hoang1302/BOARD_ADS/hardware/v2.0/docs/images/user-2026-10-26/README.md

# Bộ ảnh board ADS V2 do tác giả cung cấp

_Cập nhật ngày 26/10/2026. Bộ ảnh chính được lấy từ IMAGE/3D của project V2._

## 🖼️ Top — cấu hình nRF52840

Board V2 với module nRF52840 và ADS1299

Ảnh `top_nRF52840.png` mô tả vị trí module nRF52840 được lắp, vị trí ESP32 để trống.

## 🖼️ Top — cấu hình ESP32

Board V2 với kit ESP32 và module ADS1299

Ảnh `top_esp32.png` mô tả kit ESP32 được lắp thay cho nRF52840. Hai cấu hình là lựa chọn thay thế; không cắm đồng thời hai bộ xử lý.

## 🖼️ Mặt dưới

Mặt dưới board V2 và mô hình boost

Ảnh `Bottom.png` thể hiện cụm nguồn U1/U2/U3 và mô hình module boost ở mặt dưới. Tất cả ảnh trên là hình CAD do tác giả cung cấp, chưa phải ảnh lắp ráp hoặc báo cáo DRC.

## 📋 Ảnh layout và schematic tham khảo

- [Top Layer 2D](2d_toplayer.png) và [Bottom Layer 2D](2d_bottomlayer.png) được giữ làm tài liệu xem routing; hai ảnh này không thay thế bộ ảnh 3D chính ở trên.
- [Schematic.png](Schematic.png) có thời điểm sửa ngày 19/10/2026; chưa xác nhận là schematic được xuất lại từ bản PCB ngày 26/10.

## 📋 Nguồn và phiên bản

Ảnh được sao chép nguyên byte, giữ nguyên tên, màu sắc, hướng và bố cục; không chỉnh sửa hoặc dựng lại bằng AI. [image-provenance.json](image-provenance.json) ghi kích thước, thời điểm file gốc và SHA-256. Nguồn Altium, BOM, pinout và Gerber không được thay thế trong lần cập nhật ảnh này.

[Giới thiệu linh kiện và cách hoạt động](../../BOARD_OVERVIEW.md) · [Ảnh 3D lịch sử ngày 25/10](../current-2026-10-25/README.md).
