hoang1302/BOARD_ADS/hardware/v2.0/docs/images/current-2026-10-25/README.md

# Ảnh PCB V2 ngày 25/10/2026

Các ảnh trong thư mục này được chụp trực tiếp từ chế độ 3D của Altium Designer 26.10.1.5, với tài liệu `BOARD_ADS _V2.0 (3).PcbDoc` đang mở và không có thay đổi chưa lưu. Mã SHA-256 của PCB đã lưu trùng file PCB V2 trong repository khi chụp.

| File | Nội dung |
| --- | --- |
| `board-3d-modules.png` | Mặt có module ADS1299, giắc VBAT và sáu giắc nguồn điện cực; hai vùng cắm bộ xử lý để trống |
| `board-3d-top.png` | Mặt có ba IC nguồn U1/U2/U3 và mô hình boost |
| `power-block.png` | Cận cảnh khối nguồn và mô hình boost, cắt từ ảnh mặt nguồn |

Ảnh được cắt từ khung nhìn Altium để lấy vùng board; không tạo lại linh kiện bằng AI và không thay đổi hình học PCB. Một số model cắm thêm hoặc chân nhô ra ngoài outline đúng như CAD đang hiển thị. Đây không phải ảnh lắp ráp, xác nhận cơ khí hay kết quả kiểm tra DRC.

Thông tin nguồn và SHA-256 ảnh nằm trong `image-provenance.json`. Ảnh cũ ngày 19–22/10 ở thư mục cha tiếp tục được giữ làm lịch sử.
