hoang1302/BOARD_ADS/hardware/v2.0/docs/PINOUT.md

# Pinout từ PCB đã lưu — V2.0

Đọc trực tiếp pad/net của PCB nguồn ngày 25/10/2026. Số pad là số trong Altium, không xác nhận chiều nhìn hoặc pinout module thực tế. Chưa chạy compile/ERC/ECO trong lần đóng gói này. Chỉ cắm ESP32 hoặc nRF52840 tại một thời điểm.

Tên connector bản hiện tại đã đổi sang H6–H12. Không dùng bảng J1–J10 từ các bản review cũ để đấu dây cho bản này.

## H1 — header_22p

| Pad | Net PCB |
| --- | --- |
| 1 | 3V3 |
| 2 | 3V3 |
| 3 | Không gán net |
| 4 | DRDY |
| 5 | START |
| 6 | RESET |
| 7 | PWDN |
| 8 | Không gán net |
| 9 | Không gán net |
| 10 | Không gán net |
| 11 | Không gán net |
| 12 | Không gán net |
| 13 | Không gán net |
| 14 | Không gán net |
| 15 | Không gán net |
| 16 | CS |
| 17 | MOSI |
| 18 | SCLK |
| 19 | MISO |
| 20 | Không gán net |
| 21 | 5V |
| 22 | GND |

## H2 — header_22p

| Pad | Net PCB |
| --- | --- |
| 1 | GND |
| 2 | Không gán net |
| 3 | Không gán net |
| 4 | Không gán net |
| 5 | Không gán net |
| 6 | Không gán net |
| 7 | Không gán net |
| 8 | Không gán net |
| 9 | Không gán net |
| 10 | Không gán net |
| 11 | Không gán net |
| 12 | Không gán net |
| 13 | Không gán net |
| 14 | Không gán net |
| 15 | Không gán net |
| 16 | Không gán net |
| 17 | Không gán net |
| 18 | Không gán net |
| 19 | Không gán net |
| 20 | Không gán net |
| 21 | GND |
| 22 | GND |

## H3 — HEADER_13P

| Pad | Net PCB |
| --- | --- |
| 1 | PWDN |
| 2 | RESET |
| 3 | START |
| 4 | DRDY |
| 5 | CS |
| 6 | MISO |
| 7 | MOSI |
| 8 | SCLK |
| 9 | GND |
| 10 | Không gán net |
| 11 | Không gán net |
| 12 | Không gán net |
| 13 | GND |

## H4 — MODULE ADS1299

| Pad | Net PCB |
| --- | --- |
| 1 | 3V3 |
| 2 | GND |
| 3 | Không gán net |
| 4 | DRDY |
| 5 | MISO |
| 6 | Không gán net |
| 7 | SCLK |
| 8 | START |
| 9 | RESET |
| 10 | PWDN |
| 11 | MOSI |
| 12 | Không gán net |
| 13 | CS |

## H5 — HEADER_13P

| Pad | Net PCB |
| --- | --- |
| 1 | VBAT |
| 2 | Không gán net |
| 3 | GND |
| 4 | Không gán net |
| 5 | 3V3 |
| 6 | Không gán net |
| 7 | Không gán net |
| 8 | Không gán net |
| 9 | Không gán net |
| 10 | Không gán net |
| 11 | Không gán net |
| 12 | Không gán net |
| 13 | Không gán net |

## H6 — XH2.54M-2

| Pad | Net PCB |
| --- | --- |
| 1 | GND |
| 2 | VBAT |

## H7 — XH2.54M-2

| Pad | Net PCB |
| --- | --- |
| 1 | 2V5 |
| 2 | -2V5 |

## H8 — XH2.54M-2

| Pad | Net PCB |
| --- | --- |
| 1 | 2V5 |
| 2 | -2V5 |

## H9 — XH2.54M-2

| Pad | Net PCB |
| --- | --- |
| 1 | 2V5 |
| 2 | -2V5 |

## H10 — XH2.54M-2

| Pad | Net PCB |
| --- | --- |
| 1 | 2V5 |
| 2 | -2V5 |

## H11 — XH2.54M-2

| Pad | Net PCB |
| --- | --- |
| 1 | 2V5 |
| 2 | -2V5 |

## H12 — XH2.54M-2

| Pad | Net PCB |
| --- | --- |
| 1 | 2V5 |
| 2 | -2V5 |

## TP1 — TP_SMD_1P50

| Pad | Net PCB |
| --- | --- |
| 1 | VBAT |

## TP2 — TP_SMD_1P50

| Pad | Net PCB |
| --- | --- |
| 1 | -2V5 |

## TP3 — TP_SMD_1P50

| Pad | Net PCB |
| --- | --- |
| 1 | 2V5 |

## TP4 — TP_SMD_1P50

| Pad | Net PCB |
| --- | --- |
| 1 | VBAT_NEG |

## TP5 — TP_SMD_1P50

| Pad | Net PCB |
| --- | --- |
| 1 | GND |
