hoang1302/BOARD_ADS/hardware/v2.0/docs/images/2026-10-19_2d.png

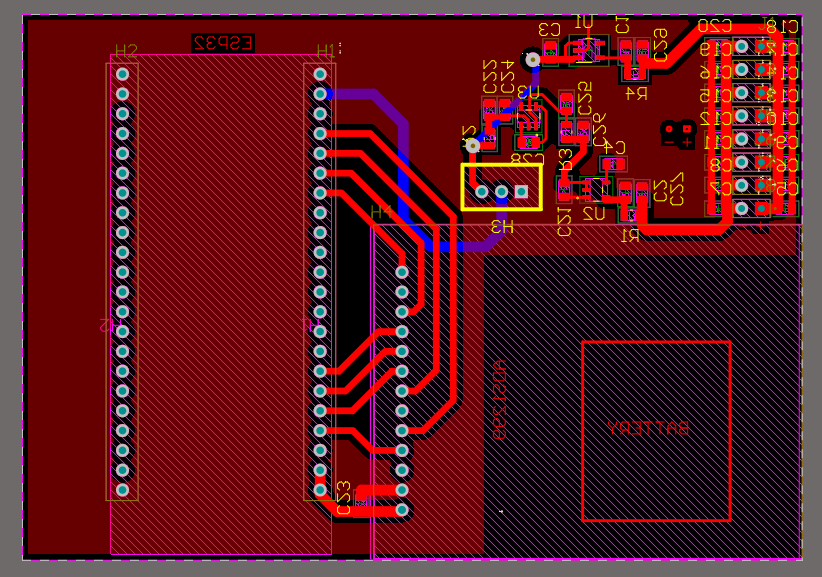
hardware/v2.0/docs/images/2026-10-19_2d.png
