hoang1302/BOARD_ADS/hardware/v2.0/docs/images/2026-10-19_3d_bottom.png

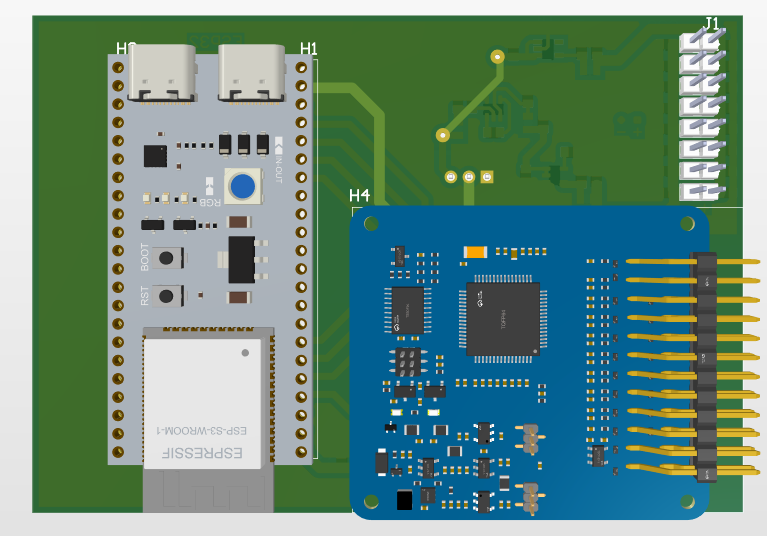
hardware/v2.0/docs/images/2026-10-19_3d_bottom.png
