hoang1302/BOARD_ADS/hardware/v2.0/docs/images/2026-10-22_3D_with_nRF.png

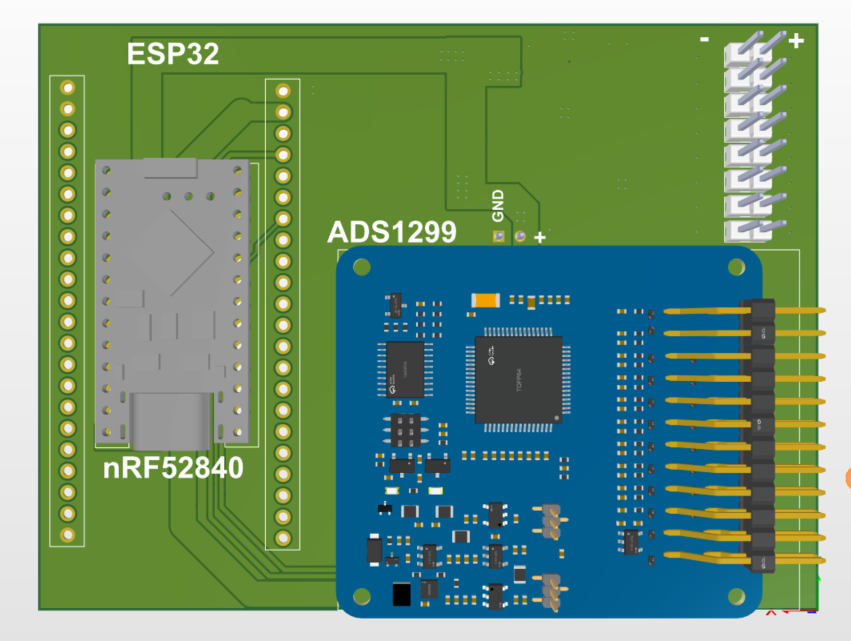
hardware/v2.0/docs/images/2026-10-22_3D_with_nRF.png
