hoang1302/BOARD_ADS/hardware/v2.0/docs/images/current-2026-10-25/board-3d-top.png

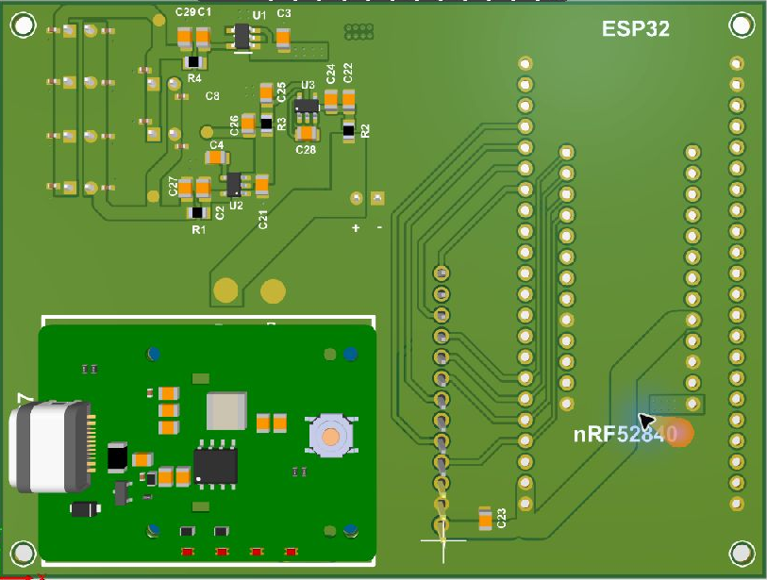
hardware/v2.0/docs/images/current-2026-10-25/board-3d-top.png
