hoang1302/BOARD_ADS/hardware/v2.0/docs/images/current-2026-10-25/power-block.png

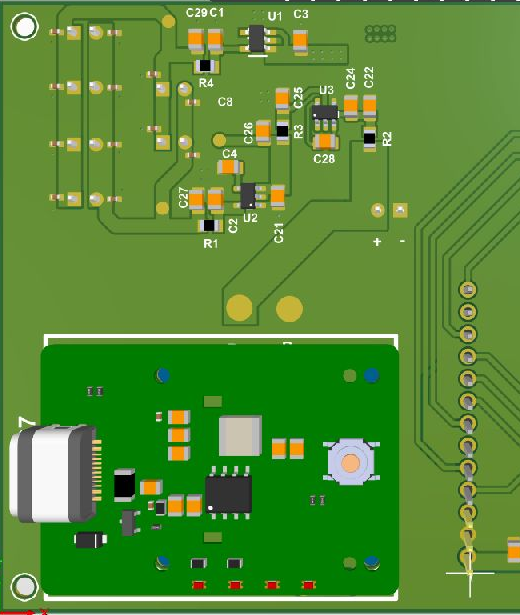
hardware/v2.0/docs/images/current-2026-10-25/power-block.png
