hoang1302/BOARD_ADS/hardware/v2.0/docs/images/user-2026-10-26/2d_bottomlayer.png

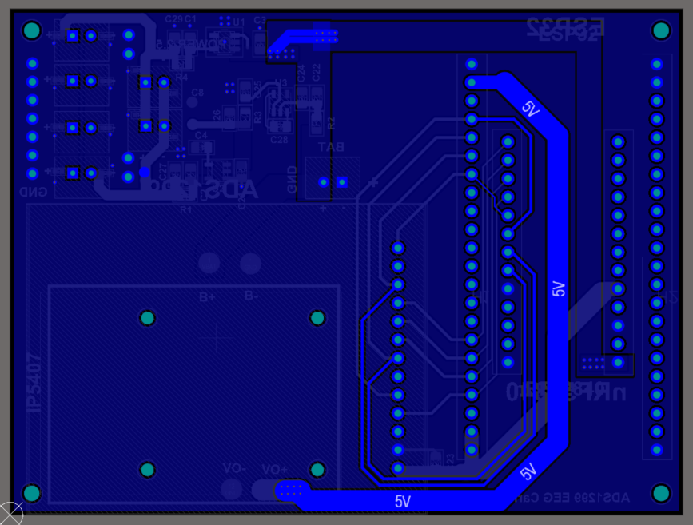
hardware/v2.0/docs/images/user-2026-10-26/2d_bottomlayer.png
