hoang1302/BOARD_ADS/hardware/bom/BOM.md

# Danh sách linh kiện tham khảo

Trích từ schematic đã lưu khi đóng gói ngày 15/10/2026, gồm **48 designator**. Bảng này phục vụ xem thiết kế, chưa phải BOM mua hàng hoặc BOM lắp ráp đã duyệt.

Giá trị lấy từ Comment; nếu Comment là `=Value1` thì đọc parameter Value1. Các trường chưa khai báo được giữ rõ là chưa có dữ liệu. Không dùng các placeholder `SET_VALUE`/`SET_VOLTAGE` để suy ra thông số linh kiện.

Footprint lấy từ PCB đã lưu. Cột Case là parameter trên schematic, chưa phải xác nhận kích thước thực tế. MPN chỉ lấy từ trường dữ liệu đã khai báo; không tự chọn mã thay thế. Các symbol module/header không mặc định bao gồm module hoặc kit tương ứng trong đơn mua hàng.

| Designator | Giá trị / chức năng | Footprint PCB | Case / Package khai báo | MPN khai báo | Trạng thái |
| --- | --- | --- | --- | --- | --- |
| C1 | 1uF | C0805L | 0402 | Chưa khai báo | Chưa chốt lắp ráp |
| C2 | 4.7uF | C0805L | 0402 | Chưa khai báo | Chưa chốt lắp ráp |
| C3 | 1uF | C0805L | 0402 | Chưa khai báo | Chưa chốt lắp ráp |
| C4 | 10nF | C0805L | 0402 | Chưa khai báo | Chưa chốt lắp ráp |
| C5 | 100nF | C0805L | 0402 | Chưa khai báo | Chưa chốt lắp ráp |
| C6 | 100nF | C0805L | 0402 | Chưa khai báo | Chưa chốt lắp ráp |
| C7 | 100nF | C0805L | 0402 | Chưa khai báo | Chưa chốt lắp ráp |
| C8 | 100nF | C0805L | 0402 | Chưa khai báo | Chưa chốt lắp ráp |
| C9 | 100nF | C0805L | 0402 | Chưa khai báo | Chưa chốt lắp ráp |
| C10 | 100nF | C0805L | 0402 | Chưa khai báo | Chưa chốt lắp ráp |
| C11 | 100nF | C0805L | 0402 | Chưa khai báo | Chưa chốt lắp ráp |
| C12 | 100nF | C0805L | 0402 | Chưa khai báo | Chưa chốt lắp ráp |
| C13 | 100nF | C0805L | 0402 | Chưa khai báo | Chưa chốt lắp ráp |
| C14 | 100nF | C0805L | 0402 | Chưa khai báo | Chưa chốt lắp ráp |
| C15 | 100nF | C0805L | 0402 | Chưa khai báo | Chưa chốt lắp ráp |
| C16 | 100nF | C0805L | 0402 | Chưa khai báo | Chưa chốt lắp ráp |
| C17 | 100nF | C0805L | 0402 | Chưa khai báo | Chưa chốt lắp ráp |
| C18 | 100nF | C0805L | 0402 | Chưa khai báo | Chưa chốt lắp ráp |
| C19 | 100nF | C0805L | 0402 | Chưa khai báo | Chưa chốt lắp ráp |
| C20 | 100nF | C0805L | 0402 | Chưa khai báo | Chưa chốt lắp ráp |
| C21 | 4.7uF | C0805L | 0402 | Chưa khai báo | Chưa chốt lắp ráp |
| C22 | 10uF | C0805L | 0402 | Chưa khai báo | Chưa chốt lắp ráp |
| C23 | 100nF | C0805L | 0402 | Chưa khai báo | Chưa chốt lắp ráp |
| C24 | 1uF | C0805L | 0402 | Chưa khai báo | Chưa chốt lắp ráp |
| C25 | 1uF | C0805L | 0402 | Chưa khai báo | Chưa chốt lắp ráp |
| C26 | 10uF | C0805L | 0402 | Chưa khai báo | Chưa chốt lắp ráp |
| C27 | 10uF | C0805L | 0402 | Chưa khai báo | Chưa chốt lắp ráp |
| C28 | 1uF | C0805L | 0402 | Chưa khai báo | Chưa chốt lắp ráp |
| C29 | 10uF | C0805L | 0402 | Chưa khai báo | Chưa chốt lắp ráp |
| H1 | HEADER_22P | header_22p | Chưa khai báo | Chưa khai báo | Chưa chốt lắp ráp |
| H2 | HEADER_22P | header_22p | Chưa khai báo | Chưa khai báo | Chưa chốt lắp ráp |
| H3 | POWER | XH2.54M-3 | Chưa khai báo | Chưa khai báo | Chưa chốt lắp ráp |
| H4 | MODULE ADS | MODULE ADS1299 | Chưa khai báo | Chưa khai báo | Chưa chốt lắp ráp |
| J1 | HEADER 2P | HEADER_2P | Chưa khai báo | 3-644456-2 | Chưa chốt lắp ráp |
| J2 | HEADER 2P | HEADER_2P | Chưa khai báo | 3-644456-2 | Chưa chốt lắp ráp |
| J3 | HEADER 2P | HEADER_2P | Chưa khai báo | 3-644456-2 | Chưa chốt lắp ráp |
| J4 | HEADER 2P | HEADER_2P | Chưa khai báo | 3-644456-2 | Chưa chốt lắp ráp |
| J5 | HEADER 2P | HEADER_2P | Chưa khai báo | 3-644456-2 | Chưa chốt lắp ráp |
| J6 | HEADER 2P | HEADER_2P | Chưa khai báo | 3-644456-2 | Chưa chốt lắp ráp |
| J7 | HEADER 2P | HEADER_2P | Chưa khai báo | 3-644456-2 | Chưa chốt lắp ráp |
| J8 | HEADER 2P | HEADER_2P | Chưa khai báo | 3-644456-2 | Chưa chốt lắp ráp |
| R1 | 0R | R0805 | 0805 | Chưa khai báo | Chưa chốt lắp ráp |
| R2 | 0R | R0805 | 0805 | Chưa khai báo | Chưa chốt lắp ráp |
| R3 | 0R | R0805 | 0805 | Chưa khai báo | Chưa chốt lắp ráp |
| R4 | 0R | R0805 | 0805 | Chưa khai báo | Chưa chốt lắp ráp |
| U1 | LP5907MFX-2.5/NOPB | DBV0005A_M | Chưa khai báo | LP5907MFX-2.5/NOPB | Chưa chốt lắp ráp |
| U2 | TPS72325DBVR | SOT95P280X145-5N | SOT-23-5 Texas Instruments | TPS72325DBVR | Chưa chốt lắp ráp |
| U3 | TPS60403DBVR | SOT95P280X145-5N | SOT-23-5 Texas Instruments | TPS60403DBVR | Chưa chốt lắp ráp |

## Trước khi đặt linh kiện

- Chốt MPN, nhà sản xuất, dung sai, điện áp/công suất và package theo linh kiện thực tế.
- Đối chiếu schematic model với footprint PCB và bản vẽ linh kiện.
- Chốt linh kiện lắp, DNP, module mua riêng và yêu cầu connector.
- C1–C29 khai báo Case/Package = 0402, trong khi model hiện tại là C0805L. Cần xác nhận và đồng bộ trước khi lập BOM mua hàng.
