hoang1302/BOARD_ADS/hardware/v2.0/docs/BOM.md

# BOM tham khảo — BOARD_ADS V2.0

Trích từ schematic và PCB đã lưu ngày 25/10/2026, gồm 49 designator. Đây là BOM tham khảo, chưa phải BOM mua hàng hoặc lắp ráp đã duyệt. Footprint lấy từ PCB; Case và MPN lấy từ schematic, không tự suy ra mã mua hàng từ tên footprint.

| Designator | Giá trị / Comment | Symbol | Footprint PCB | Case khai báo | MPN khai báo |
| --- | --- | --- | --- | --- | --- |
| C1 | 1uF | C0805 | C0805L | 0402 | Chưa khai báo |
| C2 | 4.7uF | C0805 | C0805L | 0402 | Chưa khai báo |
| C3 | 1uF | C0805 | C0805L | 0402 | Chưa khai báo |
| C4 | 10nF | C0805 | C0805L | 0402 | Chưa khai báo |
| C5 | 100nF | C0805 | C0402L | 0402 | Chưa khai báo |
| C6 | 100nF | C0805 | C0402L | 0402 | Chưa khai báo |
| C7 | 100nF | C0805 | C0402L | 0402 | Chưa khai báo |
| C8 | 100nF | C0805 | C0402L | 0402 | Chưa khai báo |
| C9 | 100nF | C0805 | C0402L | 0402 | Chưa khai báo |
| C10 | 100nF | C0805 | C0402L | 0402 | Chưa khai báo |
| C11 | 100nF | C0805 | C0402L | 0402 | Chưa khai báo |
| C12 | 100nF | C0805 | C0402L | 0402 | Chưa khai báo |
| C13 | 100nF | C0805 | C0402L | 0402 | Chưa khai báo |
| C14 | 100nF | C0805 | C0402L | 0402 | Chưa khai báo |
| C15 | 100nF | C0805 | C0402L | 0402 | Chưa khai báo |
| C16 | 100nF | C0805 | C0402L | 0402 | Chưa khai báo |
| C21 | 4.7uF | C0805 | C0805L | 0402 | Chưa khai báo |
| C22 | 10uF | C0805 | C0805L | 0402 | Chưa khai báo |
| C23 | 100nF | C0805 | C0805L | 0402 | Chưa khai báo |
| C24 | 1uF | C0805 | C0805L | 0402 | Chưa khai báo |
| C25 | 1uF | C0805 | C0805L | 0402 | Chưa khai báo |
| C26 | 10uF | C0805 | C0805L | 0402 | Chưa khai báo |
| C27 | 10uF | C0805 | C0805L | 0402 | Chưa khai báo |
| C28 | 1uF | C0805 | C0805L | 0402 | Chưa khai báo |
| C29 | 10uF | C0805 | C0805L | 0402 | Chưa khai báo |
| H1 | HEADER_22P | HEADER_22P | header_22p | Chưa khai báo | Chưa khai báo |
| H2 | HEADER_22P | HEADER_22P | header_22p | Chưa khai báo | Chưa khai báo |
| H3 | Header_13p | Header_13p | HEADER_13P | Chưa khai báo | Chưa khai báo |
| H4 | MODULE ADS | MODULE_ADS | MODULE ADS1299 | Chưa khai báo | Chưa khai báo |
| H5 | Header_13p | Header_13p | HEADER_13P | Chưa khai báo | Chưa khai báo |
| H6 | Header 2P 2.54 Duc Thang | Header 2P 2.54 Duc Thang | XH2.54M-2 | Chưa khai báo | Chưa khai báo |
| H7 | Header 2P 2.54 Duc Thang | Header 2P 2.54 Duc Thang | XH2.54M-2 | Chưa khai báo | Chưa khai báo |
| H8 | Header 2P 2.54 Duc Thang | Header 2P 2.54 Duc Thang | XH2.54M-2 | Chưa khai báo | Chưa khai báo |
| H9 | Header 2P 2.54 Duc Thang | Header 2P 2.54 Duc Thang | XH2.54M-2 | Chưa khai báo | Chưa khai báo |
| H10 | Header 2P 2.54 Duc Thang | Header 2P 2.54 Duc Thang | XH2.54M-2 | Chưa khai báo | Chưa khai báo |
| H11 | Header 2P 2.54 Duc Thang | Header 2P 2.54 Duc Thang | XH2.54M-2 | Chưa khai báo | Chưa khai báo |
| H12 | Header 2P 2.54 Duc Thang | Header 2P 2.54 Duc Thang | XH2.54M-2 | Chưa khai báo | Chưa khai báo |
| R1 | 0R | R0805 | R0805 | 0805 | Chưa khai báo |
| R2 | 0R | R0805 | R0805 | 0805 | Chưa khai báo |
| R3 | 0R | R0805 | R0805 | 0805 | Chưa khai báo |
| R4 | 0R | R0805 | R0805 | 0805 | Chưa khai báo |
| TP1 | TP_? | TEST_POINT | TP_SMD_1P50 | Chưa khai báo | Chưa khai báo |
| TP2 | TP_? | TEST_POINT | TP_SMD_1P50 | Chưa khai báo | Chưa khai báo |
| TP3 | TP_? | TEST_POINT | TP_SMD_1P50 | Chưa khai báo | Chưa khai báo |
| TP4 | TP_? | TEST_POINT | TP_SMD_1P50 | Chưa khai báo | Chưa khai báo |
| TP5 | TP_? | TEST_POINT | TP_SMD_1P50 | Chưa khai báo | Chưa khai báo |
| U1 | LP5907MFX-2.5/NOPB | LP5907MFX-2.5NOPB | DBV0005A_M | Chưa khai báo | LP5907MFX-2.5/NOPB |
| U2 | TPS72325DBVR | TPS72325DBVR | SOT95P280X145-5N | SOT-23-5 Texas Instruments | TPS72325DBVR |
| U3 | TPS60403DBVR | TPS60403DBVR | SOT95P280X145-5N | SOT-23-5 Texas Instruments | TPS60403DBVR |

## Các điểm cần đối chiếu trước khi mua

- Schematic còn nhiều tụ có Case/Package = 0402 trong khi footprint PCB là C0805L. C5–C16 đang dùng C0402L trên PCB; xem từng dòng và file nguồn trước khi cập nhật thư viện.
- H6–H12 dùng symbol `Header 2P 2.54 Duc Thang` nhưng footprint PCB là `XH2.54M-2`. Cần kiểm tra model schematic, hình học và giắc thực tế trước khi ECO/Update From Libraries.
- Test point có Comment `TP_?`; xem net tại bảng pinout để xác định chức năng.
- Chốt điện áp, dung sai, dòng tải, MPN và linh kiện/module mua riêng. Module ESP32, nRF52840, ADS1299 và boost không được tự coi là đã nằm trong BOM mua hàng chỉ vì có header hoặc 3D body.
