hoang1302/BOARD_ADS/hardware/v2.0/docs/BOM.csv

designator | value | symbol | pcb_footprint | case | mpn
C1 | 1uF | C0805 | C0805L | 0402
C2 | 4.7uF | C0805 | C0805L | 0402
C3 | 1uF | C0805 | C0805L | 0402
C4 | 10nF | C0805 | C0805L | 0402
C5 | 100nF | C0805 | C0402L | 0402
C6 | 100nF | C0805 | C0402L | 0402
C7 | 100nF | C0805 | C0402L | 0402
C8 | 100nF | C0805 | C0402L | 0402
C9 | 100nF | C0805 | C0402L | 0402
C10 | 100nF | C0805 | C0402L | 0402
C11 | 100nF | C0805 | C0402L | 0402
C12 | 100nF | C0805 | C0402L | 0402
C13 | 100nF | C0805 | C0402L | 0402
C14 | 100nF | C0805 | C0402L | 0402
C15 | 100nF | C0805 | C0402L | 0402
C16 | 100nF | C0805 | C0402L | 0402
C21 | 4.7uF | C0805 | C0805L | 0402
C22 | 10uF | C0805 | C0805L | 0402
C23 | 100nF | C0805 | C0805L | 0402
C24 | 1uF | C0805 | C0805L | 0402
C25 | 1uF | C0805 | C0805L | 0402
C26 | 10uF | C0805 | C0805L | 0402
C27 | 10uF | C0805 | C0805L | 0402
C28 | 1uF | C0805 | C0805L | 0402
C29 | 10uF | C0805 | C0805L | 0402
H1 | HEADER_22P | HEADER_22P | header_22p
H2 | HEADER_22P | HEADER_22P | header_22p
H3 | Header_13p | Header_13p | HEADER_13P
H4 | MODULE ADS | MODULE_ADS | MODULE ADS1299
H5 | Header_13p | Header_13p | HEADER_13P
H6 | Header 2P 2.54 Duc Thang | Header 2P 2.54 Duc Thang | XH2.54M-2
H7 | Header 2P 2.54 Duc Thang | Header 2P 2.54 Duc Thang | XH2.54M-2
H8 | Header 2P 2.54 Duc Thang | Header 2P 2.54 Duc Thang | XH2.54M-2
H9 | Header 2P 2.54 Duc Thang | Header 2P 2.54 Duc Thang | XH2.54M-2
H10 | Header 2P 2.54 Duc Thang | Header 2P 2.54 Duc Thang | XH2.54M-2
H11 | Header 2P 2.54 Duc Thang | Header 2P 2.54 Duc Thang | XH2.54M-2
H12 | Header 2P 2.54 Duc Thang | Header 2P 2.54 Duc Thang | XH2.54M-2
R1 | 0R | R0805 | R0805 | 0805
R2 | 0R | R0805 | R0805 | 0805
R3 | 0R | R0805 | R0805 | 0805
R4 | 0R | R0805 | R0805 | 0805
TP1 | TP_? | TEST_POINT | TP_SMD_1P50
TP2 | TP_? | TEST_POINT | TP_SMD_1P50
TP3 | TP_? | TEST_POINT | TP_SMD_1P50
TP4 | TP_? | TEST_POINT | TP_SMD_1P50
TP5 | TP_? | TEST_POINT | TP_SMD_1P50
U1 | LP5907MFX-2.5/NOPB | LP5907MFX-2.5NOPB | DBV0005A_M |  | LP5907MFX-2.5/NOPB
U2 | TPS72325DBVR | TPS72325DBVR | SOT95P280X145-5N | SOT-23-5 Texas Instruments | TPS72325DBVR
U3 | TPS60403DBVR | TPS60403DBVR | SOT95P280X145-5N | SOT-23-5 Texas Instruments | TPS60403DBVR
