hoang1302/BOARD_ADS/hardware/v2.0/manufacturing/README.md

# Dữ liệu chế tạo V2.0

**Chưa có gói chế tạo được xác nhận khớp bản nguồn ngày 25/10/2026.**

ZIP trong `archive-2026-10-22/` được sao chép nguyên byte từ Gerber người thiết kế đã xuất ngày 22/10. Ngày sửa PCB nguồn gần nhất là 25/10. Thời điểm file không chứng minh chắc chắn hình học đã đổi, nhưng cũng không đủ để xác nhận hai bản khớp nhau. Không dùng ZIP này làm bộ đặt mạch cuối cùng trước khi xuất lại hoặc đối chiếu đầy đủ.

Gói được kiểm tra tính toàn vẹn ZIP và mã SHA-256 khi đóng gói; chưa được duyệt CAM, drill/outline hoặc DFM. Nội dung ZIP nằm trong `../docs/output-inventory.json`.

Xem [trạng thái và các bước chốt đầu ra](../docs/VALIDATION.md).
