hoang1302/BOARD_ADS/hardware/schematic/BOARD_ADS_Schematic.pdf

LDO 2.5V | LDO -2.5V

# INVERTER

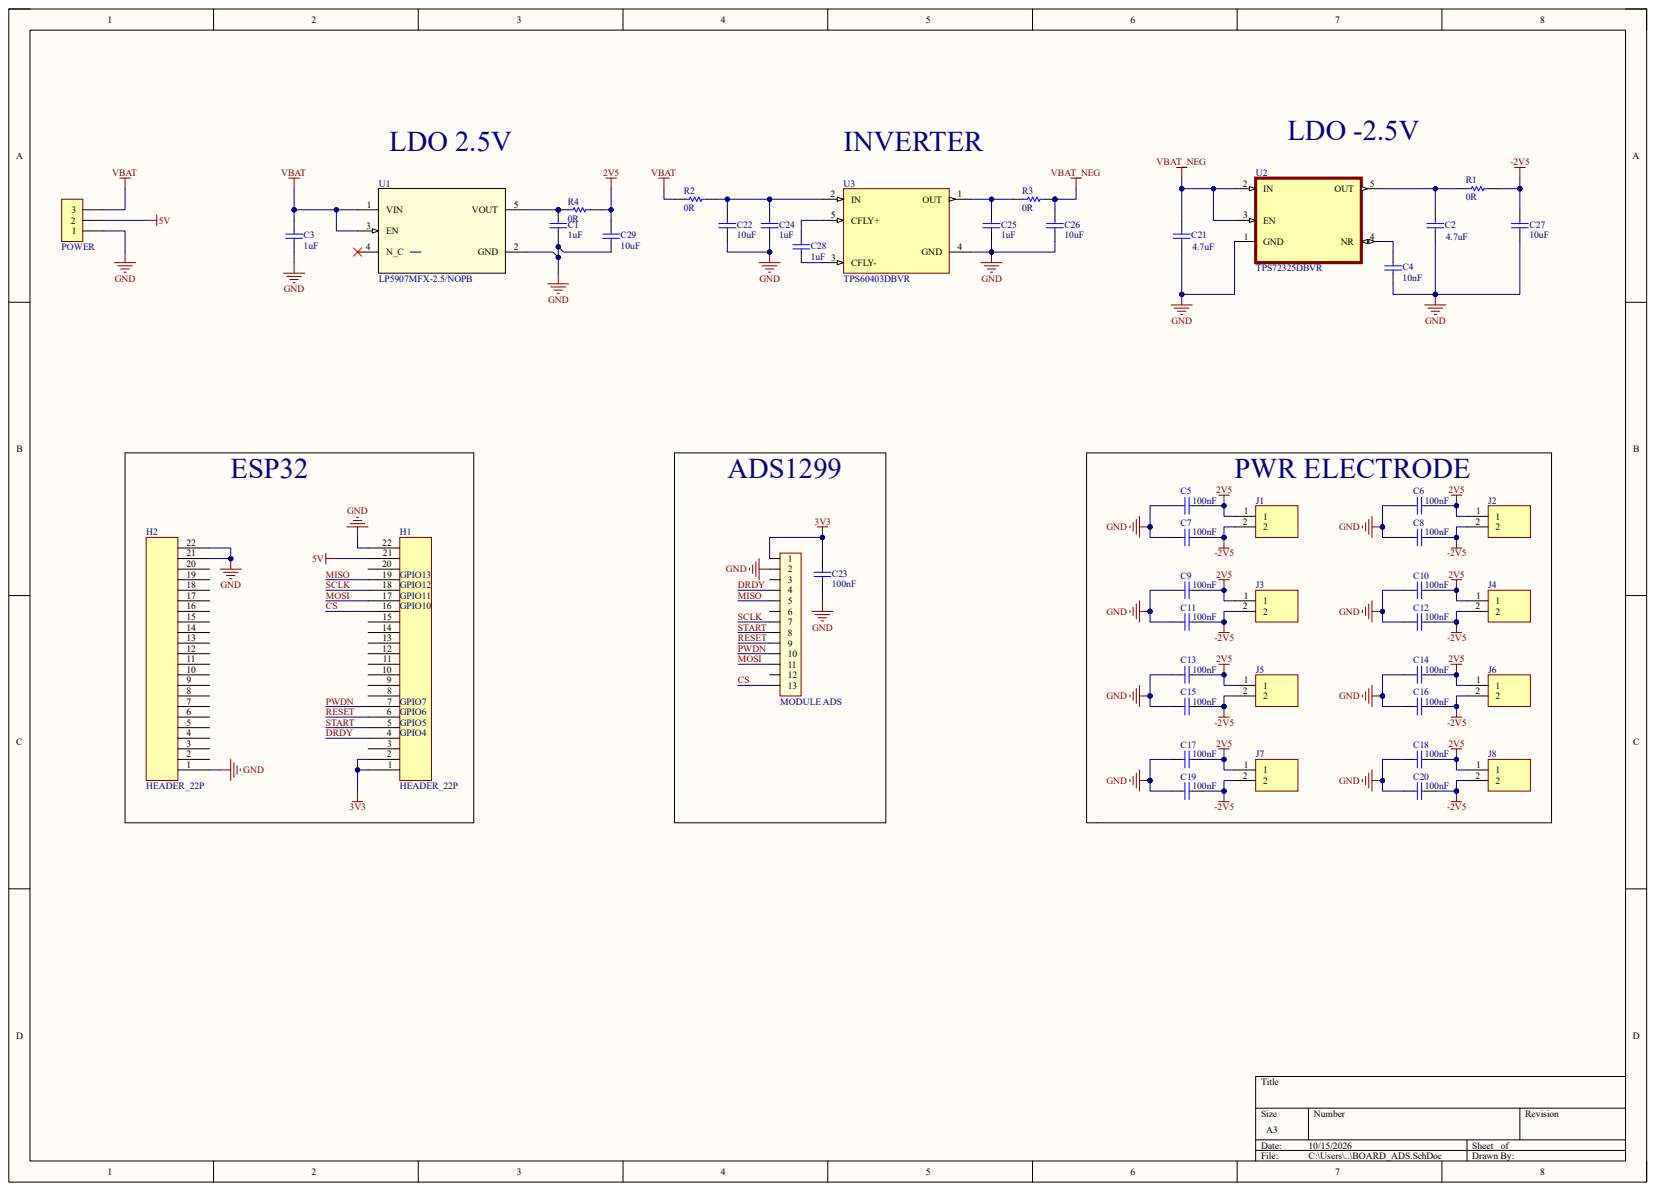
[picture p15: page 1]
