hoang1302/BOARD_ADS/hardware/v2.0/docs/archive-2026-10-19/BOARD_ADS_V2.0_Schematic_2026-10-19.pdf

LDO 2.5V | LDO -2.5V

# INVERTER

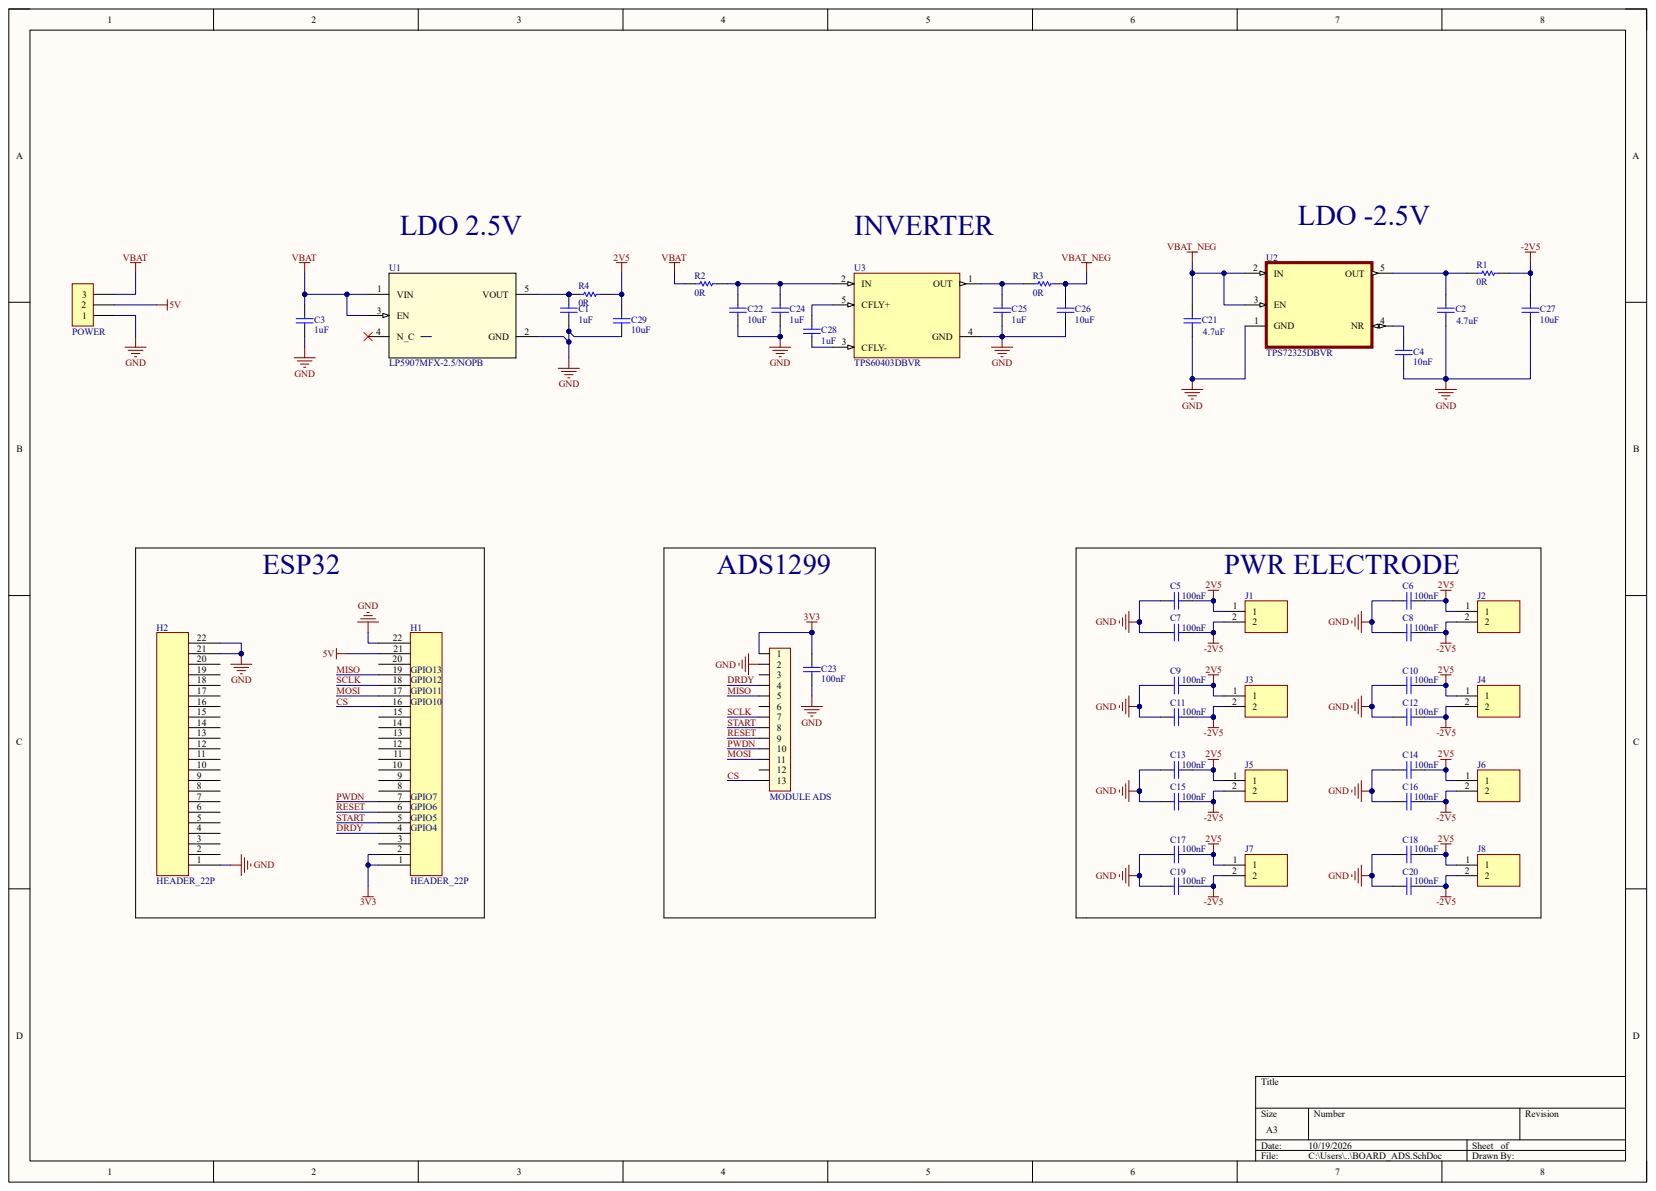
[picture p16: page 1]
