hoang1302/BOARD_ADS/(list of files, drawings)

Other design files:
hardware/altium/BOARD_ADS.PcbDoc
hardware/altium/BOARD_ADS.PcbLib
hardware/altium/BOARD_ADS.PrjPcb
hardware/altium/BOARD_ADS.SchDoc
hardware/altium/BOARD_ADS.SchLib
hardware/altium/PCB1.PcbDoc
hardware/v2.0/altium/BOARD_ADS _V2.0 (1).PcbLib
hardware/v2.0/altium/BOARD_ADS _V2.0 (1).PrjPcb
hardware/v2.0/altium/BOARD_ADS _V2.0 (1).SchDoc
hardware/v2.0/altium/BOARD_ADS _V2.0 (1).SchLib
hardware/v2.0/altium/BOARD_ADS _V2.0 (3).PcbDoc
