hoang1302/BOARD_ADS/(commit log)

2026-10-15 Add Altium design, libraries and Vietnamese prototype documentation
    [BOARD_ADS.PcbDoc, BOARD_ADS.PcbLib, BOARD_ADS.PrjPcb, BOARD_ADS.SchDoc, BOARD_ADS.SchLib, PCB1.PcbDoc]
2026-10-24 Add ADS board hardware revision V2.0 and versioned documentation
    [BOARD_ADS _V2.0 (1).PcbLib, BOARD_ADS _V2.0 (1).PrjPcb, BOARD_ADS _V2.0 (1).SchDoc, BOARD_ADS _V2.0 (1).SchLib, BOARD_ADS _V2.0 (3).PcbDoc, BOM.csv]
2026-10-25 Explain EEG carrier architecture and components with current Altium 3D images
2026-10-26 Use author-prepared PCB layer images from 26 October in project docs
2026-10-26 Show author-prepared 3D views for nRF52840, ESP32 and board bottom
